baobuibk/NANORACK_V2_OBC_1.1.1_HW/05_SMT/Note component.docx

Components that need attention

Footprint | CAP_MP_1608X90
Reference | C16, C39, C72, C78 C28, C29, C49, C50, C94, C95, C186, C187

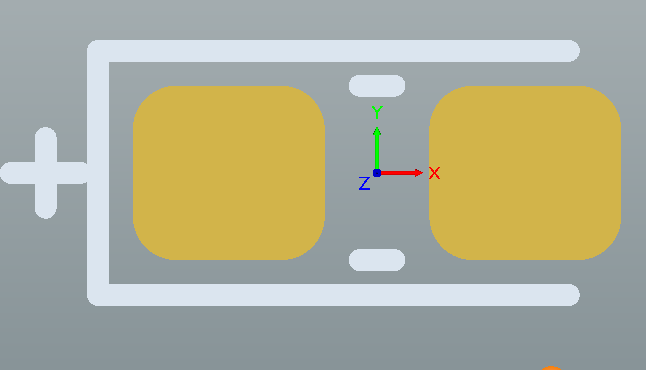
[picture p1: figure]

Silk screen draw

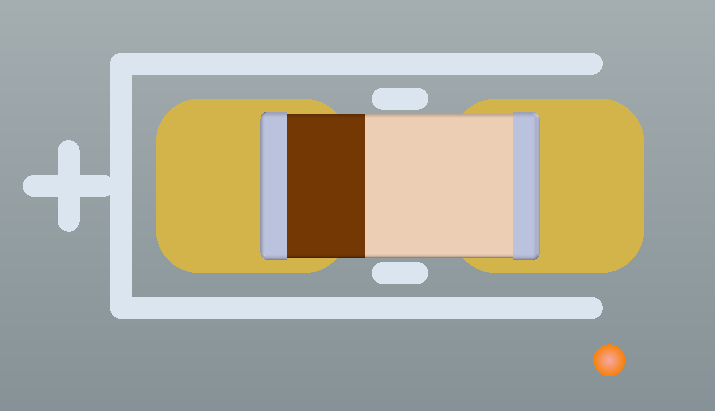
[picture p2: figure]

3D

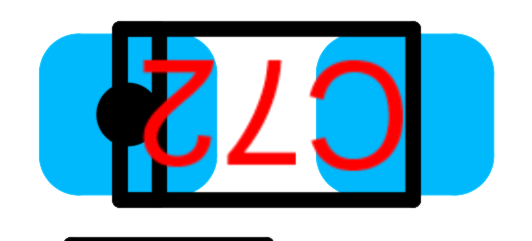
[picture p3: figure]

Assemply drawing
Note | In silkscreen, the plus mark (+) is positive of the capacitor. Dot in Assemply drawing: Anode (+)
