baobuibk/NANORACK_V2_OBC_1.1.1_HW/03_BOM/obc_ver120.xlsx

Name | Description | Designator | Quantity | Footprint | Manufacturer 1 | Manufacturer Part Number 1
0.22uF/10V | CAPC | C1, C4, C5, C8, C9, C11, C105, C107, C109, C111, C160, C161, C162, C163, C164, C165, C166, C167, C168, C169, C170, C171, C174, C175, C176, C177, C178, C179 | 28 | CAP_C_1005X60 | Murata Electronics | GCM155R71C224KE02D
0.22uF/6.3V | CAPC | C13, C14, C15, C17, C18, C19, C20, C21, C22, C23, C24, C25, C26, C27, C30, C31, C32, C33, C34, C35, C36, C37, C38, C40, C41, C42, C43, C44, C45, C46, C47, C48, C51, C52, C53, C54, C55, C56, C57, C58, C59, C60, C61, C62, C63, C64, C65, C66, C67, C68, C69, C70, C71, C73, C74, C75, C76, C77, C79, C80, C81, C82, C83, C86, C87, C88, C89, C90, C91, C92, C93, C96, C97, C98, C99, C100, C101, C102, C103, C104, C106, C108, C110, C112, C113, C114, C115, C116, C117, C118, C119, C124, C125, C126, C127, C128, C129, C130, C131, C132, C133, C134, C135, C136, C137, C138, C139, C140, C141, C142, C143, C144, C145, C146, C147, C148, C149, C150, C151, C152, C153, C154, C155, C156, C157, C158, C159, C183, C184, C191, C192, C194, C195, C196, C197, C198, C199, C200, C201, C202, C203, C204, C205, C206, C208, C209, C210, C211, C212, C213, C214, C215, C216, C217, C218, C219, C220, C221, C222 | 159 | CAP_C_1005X60 | Murata Electronics | GCM155R71C224KE02D
0.22uF/6.3V | CAPC | C185, C193 | 2 | CAP_C_1005X60 | Murata Electronics | GCM155R71C224KE02D
0R/1% | RES | R17, R61, R63, R108, R84 | 5 | RES_C_1608X60 | Panasonic | ERJ-3GEY0R00V
10k | RES 4.7K OHM 1% 1/10W 0603, P/N: ERJ-U03F4701V | R90, R91, R92, R93, R94, R95, R96, R97, R98, R99, R100, R101, R102, R103, R104, R106, R110, R111 | 18 | RES_C_1608X60 | Panasonic | ERJ-3EKF1002V
10uF/10V | CAPP | C3, C6, C10, C172, C173 | 5 | CAP_MP_2012X170 | Vishay Sprague | TP8R106M016C
10uF/6.3V | CAPP | C2, C7, C12, C207 | 4 | CAP_MP_2012X170 | Vishay Sprague | TP8R106M016C
12k | RES SMD 12K OHM 1% 1/10W 0603, P/N: ERJ-3EKF1202V | R32 | 1 | RES_C_1608X60 | Panasonic | ERJ-3EKF1202V
150060GS75000 | 430mcd Colorless transparence 520nm Emerald 140° LED0603 Light Emitting Diodes (LED) ROHS | D6, D7, D8, D9 | 4 | WL-SMCW_0603_150060xx75000 | Wurth Electronics | 150060GS75000
150060YS75000 |  | D1, D2, D3, D10, D11, D12, D13, D14, D15, D16, D17, D18 | 12 | WL-SMCW_0603_150060xx75000 | Wurth Electronics | 150060YS75000
16.5k/1% | RES SMD 16.5K OHM 1% 1/10W 0603, P/N: ERJ-3EKF1652V | R19, R18 | 2 | RES_C_1608X60 | Panasonic | ERJ-3EKF1652V
16pF/6.3V | CAPC | C223, C224 | 2 | CAP_C_1005X60 | Murata Electronics | GJM1555C1H160FB01J
1k | RES | R1, R2, R3, R24, R25, R26, R27, R31, R44, R60, R62, R64, R65, R66, R68, R69, R82, R83, R87, R109, R55 | 21 | RES_C_1608X60 | Panasonic | ERJ-3EKF1001V
1M | RES SMD 12K OHM 1% 1/10W 0603, P/N: ERJ-3EKF1202V | R37 | 1 | RES_C_1608X60 | Panasonic | ERJ-3EKF1004V
1uF/6.3V | CAPP | C16, C39, C72, C78 | 4 | CAP_MP_1608X90 | Vishay Sprague | TP8M105M010C
20pF/6.3V | CAPC | C84, C85 | 2 | CAP_C_1005X60 | Murata Electronics | GCM1555C1H200GA16D
24LC04BT-E/SN | 4Kbit, 400kHz, 2.5V, I2C Serial EEPROM, 8-Pin SOIC 150mil, Extended Temperature, Tape and Reel | U14 | 1 | SOIC-SN8_L | Microchip | 24LC04BT-E/SN
4.7k | RES | R4, R5, R6, R7, R8, R9, R10, R11, R12, R13, R14, R16, R20, R21, R22, R23, R30, R33, R34, R35, R36, R38, R39, R40, R41, R42, R43, R45, R46, R47, R48, R49, R50, R52, R53, R54, R67, R70, R71, R72, R73, R74, R75, R76, R77, R78, R79, R80, R81, R85, R86, R88, R89, R112 | 54 | RES_C_1608X60 | Panasonic | ERJ-U03F4701V
4.7uF/6.3V | CAPC | C180, C181, C182, C188, C189, C190 | 6 | CAP_C_1005X60 | Murata Electronics | GRT155D70J475ME13J
4.7uF/6.3V | CAPP | C28, C29, C49, C50, C94, C95, C186, C187 | 8 | CAP_MP_1608X90 | Vishay Sprague | TP8M475M010C
5006 | PC TEST POINT COMPACT BLACK | TP3 | 1 | FP-5006-MFG | Keystone Electronics | 5006
53261-0271 | PicoBlade(TM) Header, Right Angle, -40 to 85 degC, 2-Pin SMD, RoHS, Tape and Reel | J1 | 1 | MOLX-53261-0271_V | Molex | 53261-0271
77313-101-14LF |  | J18 | 1 | AMPHENOL_77313-101-14LF | Amphenol ICC / FCI | 77313-101-14LF
9774015151R | 9774015151R WA-SMSI SMT Steel Spacer, M2.5 Internal non Stop | MP1, MP2, MP3, MP4 | 4 | 9774015151 | Wurth Electronics | 9774015151R
ADUM1250WSRZ | IÂ²C Digital Isolator 2500Vrms 2 Channel 1Mbps 25kV/Âµs CMTI 8-SOIC (0.154", 3.90mm Width) | U15, U16, U24, U25, U27 | 5 | SOIC127P602X173-8N | Analog Devices | ADUM1250WSRZ
Bus_M.2_Socket_M |  | J16 | 1 | M.2 M Key socket | JAE Electronics | SM3ZS067U410AMR1000
ECS-240-12-37B-CKY-TR |  | Y1 | 1 | XTAL_ECS-240-12-37B-CKY-TR | ECS International | ECS-240-12-37B-CKY-TR
ECS-250-12-33Q-JES-TR | 25 MHz Â±20ppm Crystal 12pF 40 Ohms 4-SMD, No Lead | Y4 | 1 | XTAL_ECS-250-12-33Q-JES-TR | ECS International | ECS-250-12-33Q-JES-TR
ECS-327ATQMV-AS-TR | XTAL OSC XO 32.7680KHZ CMOS SMD | Y2, Y3 | 2 | FP-327ATQMV-MFG | ECS International | ECS-327ATQMV-AS-TR
FSUSB42MUX | IC USB SWITCH DPDT 10MSOP | U21 | 1 | FP-846AP-MFG | ON Semiconductor / Fairchild | FSUSB42MUX
ISO7721DR | Robust EMC, dual-channel, 1/1, reinforced digital isolator 8-SOIC -55 to 125 | U18, U23 | 2 | SOIC127P602X173-8N | Texas Instruments | ISO7721DR
ISOUSB211 |  | U20 | 1 | BSSOP_65P_750W_28 | Texas Instruments | ISOUSB211DPR
LMS1585AIS-3.3/NOPB | 3A Low Dropout Fast Response Regulators, 3-pin TO-263, Pb-Free | U2 | 1 | TS3B_L | TI National Semiconductor | LMS1585AIS-3.3/NOPB | Đổi thành loại 5A
M80-5114242 |  | J3 | 1 | HARWIN_M80-5114242 | Harwin | M80-5114242
MAX14431CAEE+ | No Description Available | U17, U22 | 2 | 21-0055Q_E16MS+1F_MXM | Analog Devices | MAX14431CAEE+
MB85RS2MTAPNF-G-BDERE1 | FRAM _Ferroelectric RAM_ Memory IC 2Mb _256K x 8_ SPI 40MHz 8-SOP | U10 | 1 | SOIC127P602X173-8N | Fujitsu | MB85RS2MTAPNF-G-BDERE1
MMBT2222A | BJT, SOT-23, 40V, 600mA, NPN, 0.25W, 150°C | Q1 | 1 | SOT95P240X120-3N | Infineon | MMBT2222A
MTFC32GAZAQDW-AAT |  | U4, U7 | 2 | BGA_100_C_100P_10X17_1400X1800X150 | Micron Technology | MTFC32GAZAQDW-AAT
MX25L8006EM1I-12G | FLASH - NOR Memory IC 8Mb (1M x 8) SPI 86 MHz 8-SOP | U11 | 1 | SOIC127P602X173-8N | Macronix | MX25L8006EM1I-12G
RV-3129-C3-32.768KHZ-OPTION-A-TB-QA | Real-Time Clock Module, Temperature compensated, in 2.5 x 3.7 mm package | U8 | 1 | IC_RV-3129-C3_32.768KHZ_OPTION_A_TB_QA | Micro Crystal | RV-3129-C3-32.768KHZ-OPTION-A-TB-QA
STM32H745ZIT6 | HIGH-PERFORMANCE AND DSP WITH DP | U26 | 1 | FP-LQFP144-1A-MFG | STMicroelectronics | STM32H745ZIT3
TPL5010QDDCTQ1 |  | U9 | 1 | SOT95P280X110-6N | Texas Instruments | TPL5010QDDCTQ1
TPS7A4533DCQR | Single Output Fast Transient Response LDO, 1.5 A, Fixed 3.3 V Output, 2.1 to 20 V Input, 6-pin SOT-223 (DCQ), -40 to 125 degC, Green (RoHS & no Sb/Br) | U1, U3 | 2 | DCQ0006A_M | Texas Instruments | TPS7A4533DCQR
TS3A27518ETRTWRQ1 | IC MUX/DEMUX 1X2 24WQFN | U5, U6 | 2 | FP-RTW0024B-IPC_A | Texas Instruments | TS3A27518ETRTWRQ1
USB2642-I/ML | IC INTERFACE SPECIALIZED 48QFN | U13 | 1 | FP-48QFN-5304-7x7B-IPC_A | Microchip | USB2642-I/ML
USBLC6-2SC6 | 17V Clamp 5A (8/20Âµs) Ipp Tvs Diode Surface Mount SOT-23-6 | D5 | 1 | SOT95P280X145-6N | STMicroelectronics | USBLC6-2SC6
 | CONN RCPT 100POS SMD GOLD | CM4, CM4B | 2 |  | Hirose Electric Co Ltd | DF40C-100DS-0.4V(51) | connector cho CM4
 | THREADED STANDOFF FOR SM3ZS067U4 | MH6 | 1 |  | JAE Electronics | SM3ZS067U410-NUT1-R1200 | standoff cho khe M2
Do not place list (DNP)
0R/DNP | RES SMD 12K OHM 1% 1/10W 0603, P/N: ERJ-3EKF1202V | R105, R107 | 2 | RES_C_1608X60 | Panasonic | ERJ-3GEY0R00V
10k/DNP | RES SMD 10K OHM 1% 1/10W 0603, P/N: ERJ-3EKF1002V | R15 | 1 | RES_C_1608X60 | Panasonic | ERJ-3EKF1002V
4.7k/DNP | RES | R28, R29, R51 | 3 | RES_C_1608X60 | Panasonic | ERJ-U03F4701V
JP1/DNP |  | J2, J17 | 2 | JP1-D1T
JP2/DNP |  | J13, J14, J20, J22, J23, J24, J25, J26, J27 | 9 | JP2-D1T
JP7/DNP |  | J7 | 1 | JP7-C1T
JP8/DNP |  | J6 | 1 | JP8-C1T
JP4/DNP |  | J8, J10, J19 | 3 | JP4-C1T
M3/DNP |  | H1, H2, H3, H4 | 4 | HEX-M3
1727010/DNP | TERM BLK 2P SIDE ENT 3.81MM PCB | J11, J12 | 2 | CONN_1727010 | Phoenix Contact | 1727010
0473460001/DNP | No Description Available | J4, J9 | 2 | 47346-0001_MOL | Molex | 47346-0001
MX25L8006EM1I-12G/DNP | FLASH - NOR Memory IC 8Mb (1M x 8) SPI 86 MHz 8-SOP | U12 | 1 | SOIC127P602X173-8N | Macronix | MX25L8006EM1I-12G
