baobuibk/NANORACK_V2_OBC_1.1.1_HW/05_SMT/DRAWING_OBC_120.pdf

A

B

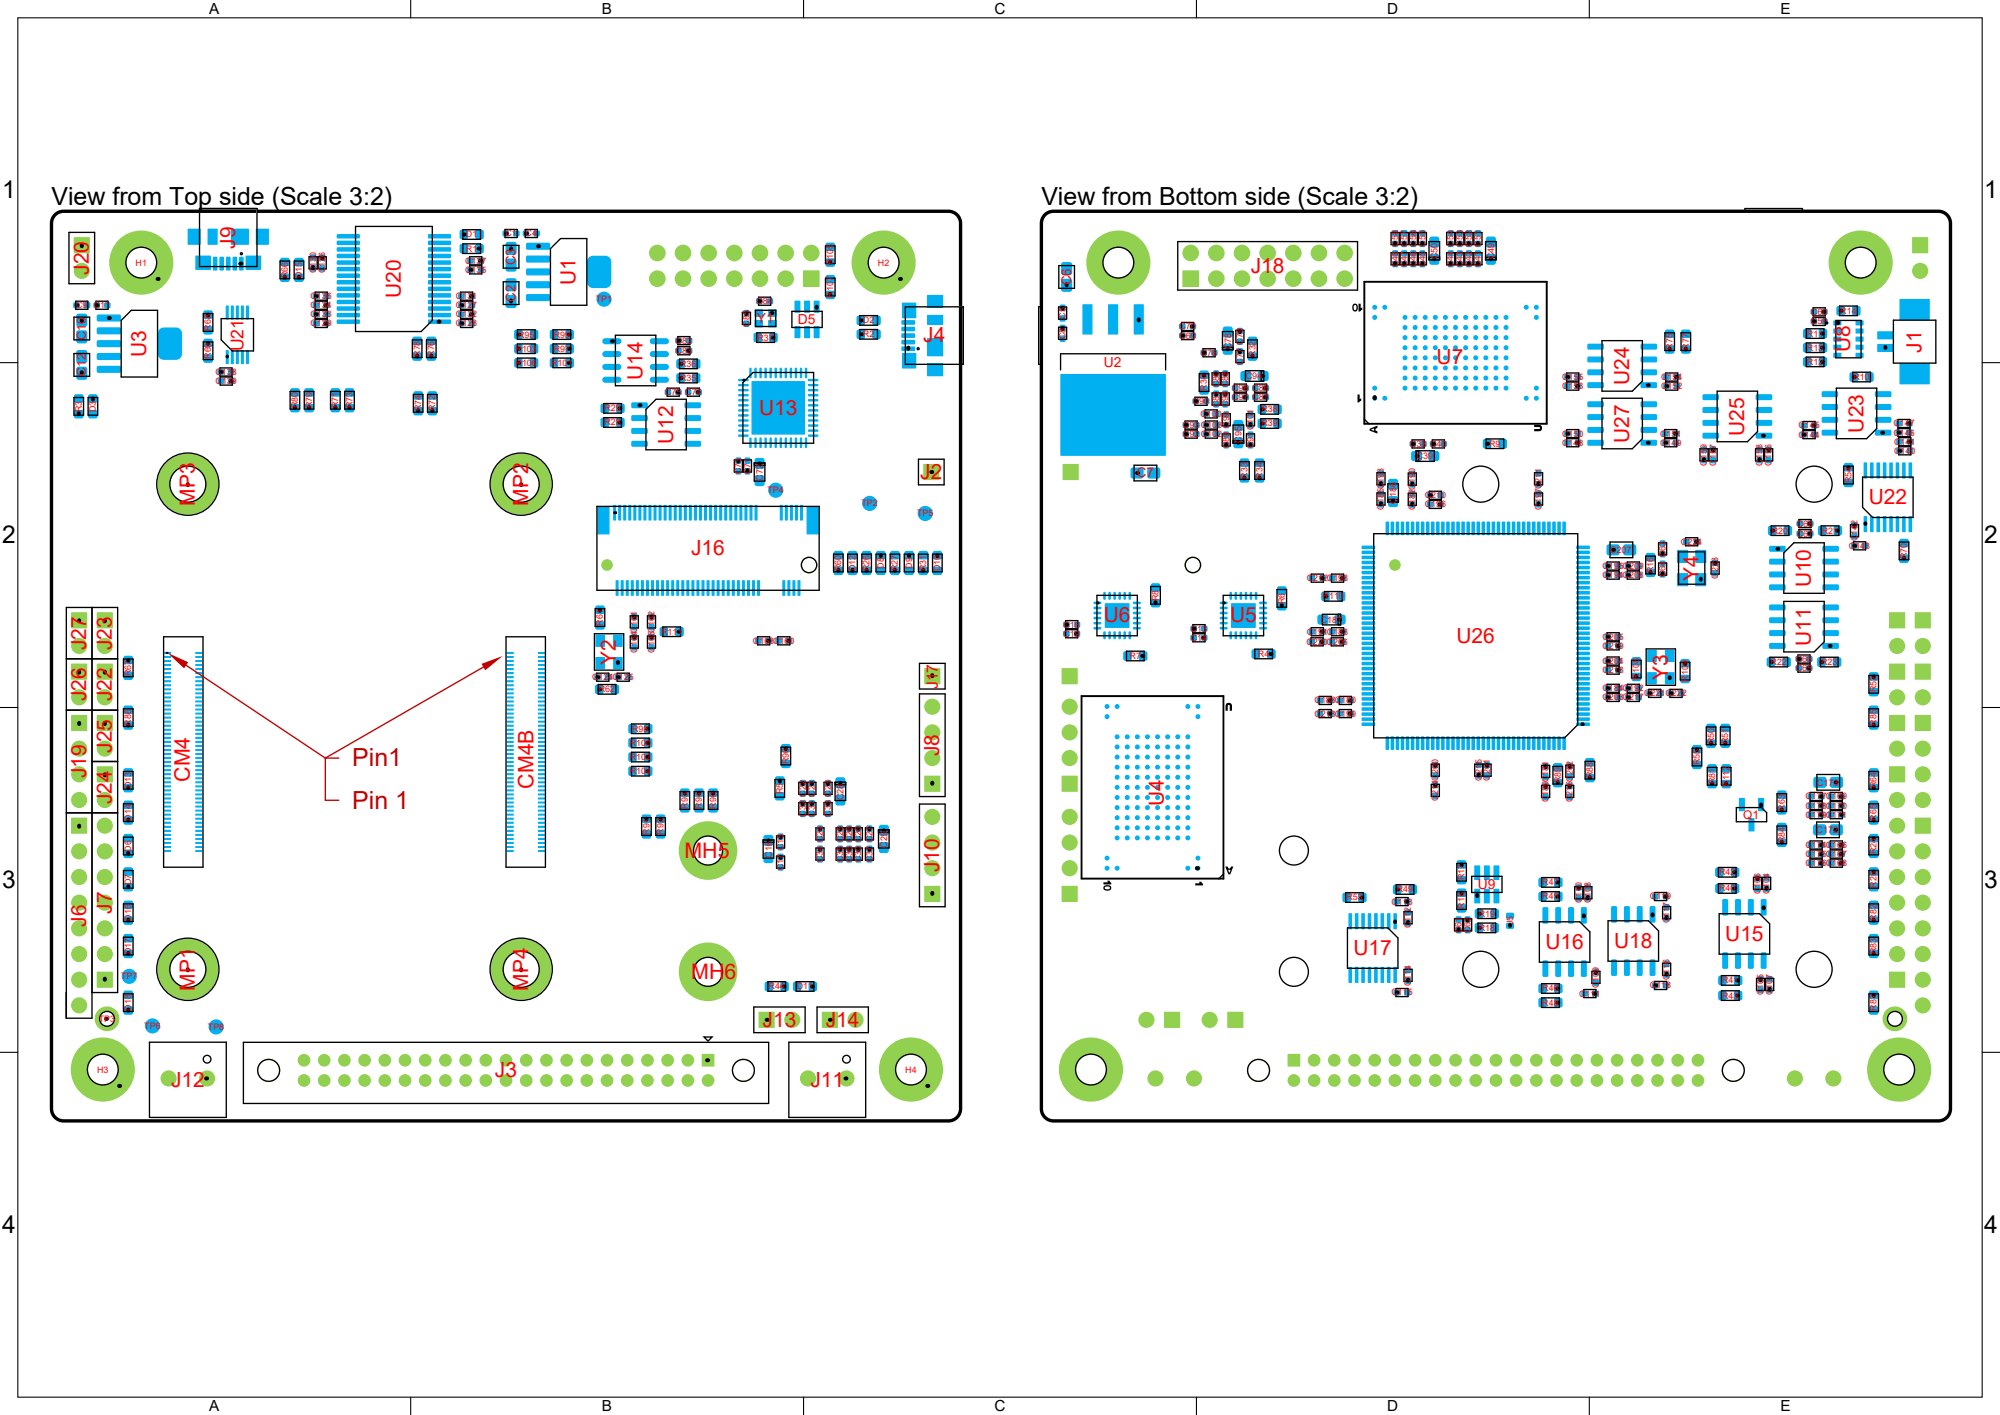
[picture p4: page 1]

View from Top side (Scale 3:2)

View from Bottom side (Scale 3:2)
