baobuibk/NANORACK_V2_OBC_1.1.1_HW/(list of files, drawings)

Other design files:
01_DESIGN/obc-v2_BOARD-CONNECT.SchDoc
01_DESIGN/obc-v2_CM4-CSI.SchDoc
01_DESIGN/obc-v2_CM4-FUNCTION.SchDoc
01_DESIGN/obc-v2_CM4-IRQ-CTRL.SchDoc
01_DESIGN/obc-v2_CM4-M2.SchDoc
01_DESIGN/obc-v2_CM4-PinOut.SchDoc
01_DESIGN/obc-v2_CM4-POWER.SchDoc
01_DESIGN/obc-v2_CM4-SPI-UART.SchDoc
01_DESIGN/obc-v2_COVER-PAGE.SchDoc
01_DESIGN/obc-v2_DEBUG.SchDoc
01_DESIGN/obc-v2_EXP-CAN-RS422.SchDoc
01_DESIGN/obc-v2_EXP-I2C-IRQ.SchDoc
01_DESIGN/obc-v2_FRAM-FLASH.SchDoc
01_DESIGN/obc-v2_INDEX.SchDoc
01_DESIGN/obc-v2_MCU-PinOut.SchDoc
01_DESIGN/obc-v2_MCU-POWER.SchDoc
01_DESIGN/obc-v2_OUT-eMMC.SchDoc
01_DESIGN/obc-v2_POWER.SchDoc
01_DESIGN/obc-v2_RTC-WDOG.SchDoc
01_DESIGN/obc-v2_TMP-eMMC.SchDoc
01_DESIGN/obc-v2_USB-HUB.SchDoc
01_DESIGN/obc_ver111.PrjPcb
