baobuibk/NANORACK_V2_OBC_1.1.1_HW/09_Review/Changelog.xlsx

V111 compare to V110
STT | Page number | Page name | Component | Nội dung | Ghi chú
1 | 12 | obc-v2_EXP-CAN-RS422 | U17, U18,U19 | Removed | Bỏ 2 IC CAN, bỏ RS422
2 | 21 | MCU_Pinout | U26C | Bỏ FDCAN1 (pin 112, 113)
3 | 21 | MCU_Pinout | U26B | Bỏ FDCAN2 (pin 72,73)
4 | 9 | DEBUG | J12 | Bỏ J12 - connector test SPI6
5 | 12 | obc-v2_EXP-CAN-RS422 | U17 | Thêm U17 - SPI ISO
6 | 21 | MCU_Pinout | U26B | SPI6 (pin 43 44 45 46) vào U17 SPI ISO
7 | 8 | obc-v2_BOARD-CONNECT | J3 | SPI ISO vào connector pin 6 7 27 28
8
9 | 12 | obc-v2_EXP-CAN-RS422 | U18 | Thêm U18 UART ISO
10 | 21 | MCU_Pinout | U26C | UART7(Pin 57 58) nối vào U18 UART ISO
11 | 8 | obc-v2_BOARD-CONNECT | J3 | U18 UART ISO nối vào pin 4, 25
12
13 | 8 | obc-v2_BOARD-CONNECT | J18 | pin 09 và 10 đổi thành nối SHIELD | SHIELD to Adaptor
14 | 8 | obc-v2_BOARD-CONNECT | J3 | Bỏ SEL0 SEL1 thay bằng SHIELD | SHIELD to EXP
15 | 14 | obc-v2_CM4-PinOut | CM4A | Bỏ SEL0 SEL1 (GPIO16,17)
16 | 8 | obc-v2_BOARD-CONNECT | J3 | Bỏ 2 tín hiệu ISO_CAN (pin 4, 25)
17 | 3 |  | U2 | Đổi thành mã LMS1585AIS-3.3/NOPB | loại 3A sang 5A, chung footprint
18 | 17 |  | R84 | Đổi thành 0R
19 |  |  |  | Thêm terminal J11 J12 cho 2 nguồn 5V
20 |  |  |  | Thêm 2 jumper J13 J14 nối 3.3V với 3.3_EXP
 |  |  |  | SPI6 Pullup MISO
 |  |  |  | CM4_SPI1_MISO pull-up
 |  |  |  | STM_SPI5_MOSI pull-up
