baobuibk/NANORACK_V2_OBC_1.1.1_HW/(commit log)

2025-03-20 đổi điện trở WDog
    [obc-v2_BOARD-CONNECT.SchDoc, obc-v2_CM4-IRQ-CTRL.SchDoc, obc-v2_RTC-WDOG.SchDoc, obc_ver111.xlsx]
2025-03-21 Layout done
    [obc-v2_EXP-CAN-RS422.SchDoc, obc-v2_MCU-PinOut.SchDoc, obc_ver111.PrjPcb, obc_ver111.xlsx]
2025-03-23 Hieu Review
    [OBC_Ver2_BoardStack.xls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]
2025-03-24 3D change
    [obc-v2_BOARD-CONNECT.SchDoc]
2025-04-01 update drawing
    [Pick Place for OBC_Ver111.csv, obc_ver111.PrjPcb]
2025-04-10 đổi thành 1.2.0
2025-04-10 Version 120
    [OBC_Ver120_stackup.xls, OBC_Ver2.xls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]
